tomaszkuehn/Heating-system/ijfw/memory/project-journal.md

<!-- ijfw-schema: v1 -->
# project-journal
- [2026-08-08T21:53:25.724Z] **decision** [esp-idf, sensor, ds18b20, lora, refactor]: Sensor/ przekształcony z .ino do aplikacji ESP-IDF
- [2026-09-24T12:07:08.839Z] **observation** [wt32-eth01, pinout, lora, e32, gpio12, gpio14, datasheet]: WT32-ETH01: IO12/IO14 are GPIO not GND (datasheet)
- [2026-09-24T15:37:29.482Z] **observation** [lora, e32, wt32-eth01, verification, no-remote-node]: LoRa wired; no RX frames — remote node absent (expected)
- [2026-09-24T15:53:58.510Z] **observation** [lora, e32, api, test-endpoint, wiring-debug]: /api/lora/test added; E32 silent — check wiring/variant
- [2026-09-24T17:10:07.536Z] **observation** [ota, rollback, httpd, ethernet, lora, troubleshooting]: OTA interrupted by bad cable; httpd jam; rollback OK
- [2026-09-24T17:13:14.581Z] **observation** [gpio, lora, audit, uart2, strapping]: GPIO audit OK: outputs configured, UART pins valid
- [2026-09-24T17:28:26.508Z] **decision** [git, restructure, submodule, commit, push]: Single repo restructure: submodule dropped, commit 20c5dc2 pushed
- [2026-09-24T20:19:27.060Z] **decision** [lora, security, design, deferred, v2]: LoRa v2 designed, NOT implemented yet (user deferred)
- [2026-09-24T20:37:23.700Z] **observation** [sensor, averaging, health, loss, lora, ota]: 8-sample avg + loss-based health deployed, STALE bug fixed
- [2026-09-26T09:39:26.930Z] **decision** [lora, pairing, hmac, esp32, bugfix]: LoRa PAIR HMAC bug fixed: tag must cover nonce
- [2026-09-26T18:09:52.155Z] **observation** [lora, sensor, bug, ack, arduino, inino]: BUG w Sensor/LoRa_sensor.ino (Arduino, wgrany build = repo, potwierdzone hashem zbudowanego .cpp): ACK kontrolera nigdy nie jest kwitowany, sensor restartuje sie co ~120 s ("No acknowledgement for too
