tomaszkuehn/Heating-system/Heating/main/app_config.h

/**
 * Global hardware / wiring configuration.
 * Centralised so it can be retargeted without touching module logic.
 */
#pragma once

#include "data_model.h"

#ifdef __cplusplus
extern "C" {
#endif

/* ---- GPIO (WT32-ETH01 V1.4 pinout) ----
 * RMII hardwired: GPIO0(clk),18(MDIO),19(TXD0),21(TX_EN),22(TXD1),
 * 23(MDC),25(RXD0),26(RXD1),27(CRS_DV).
 * GPIO16 = LAN8720 + 50 MHz oscillator power enable (must be HIGH).
 * Relocated: heating relay 16->32 (frees PHY power pin).
 * GPIO15 (former net-reset button) and GPIO2 (former LED) are now free:
 * WiFi was removed, so the reset-button watcher no longer exists. */
#define HE_GPIO_HEATING         GPIO_NUM_32   /* relay line to the furnace   */

/* ---- Sensor interface (external board over UART) ----
 * GPIO17 TX is safe; GPIO18 is MDIO → RX moved to GPIO13. */
#define HE_SENSOR_UART          UART_NUM_1
#define HE_SENSOR_UART_TX       GPIO_NUM_17
#define HE_SENSOR_UART_RX       GPIO_NUM_13
#define HE_SENSOR_BAUD          115200
#define HE_SENSOR_BUF_SIZE      256

/* ---- LoRa receiver (radio module Ebyte E32 433T20D).
 *      Receives "TT.TTT T<id>&\r\n" text lines over UART2.
 *      GPIO12/14 are free (not on RMII bus). Mode-control pins moved
 *      off GPIO25/26 (RMII RXD0/RXD1) to GPIO4/5. ---- */
#define HE_LORA_UART            UART_NUM_2
#define HE_LORA_UART_TX         GPIO_NUM_12    /* to module RXD            */
#define HE_LORA_UART_RX         GPIO_NUM_14    /* from module TXD          */
#define HE_LORA_BAUD            9600
#define HE_LORA_BUF_SIZE        256
/* RF channel of the E32 module (LoRa.txt: the node and the controller must
 * transmit on the SAME channel). freq = 410 + channel MHz, so 23 = 433 MHz,
 * which is the E32-433T20D factory default shared by the sensor modules.
 * lora_receiver_init() reads this register back at boot and rewrites it when
 * a field-reconfigured module differs. */
#define HE_LORA_CHANNEL         23             /* 433 MHz (E32 factory)    */
/* Mode-control pins (AUX / TX-RX) on the E32 module. Moved off GPIO25/26
 * (RMII RXD0/RXD1) to safe output pins GPIO4/GPIO5. */
#define HE_GPIO_LORA_AUX        GPIO_NUM_4    /* mode select (0=normal)   */
#define HE_GPIO_LORA_TXRX       GPIO_NUM_5    /* mode select (0=normal)    */
#define HE_LORA_MODE_NORMAL    0
#define HE_LORA_MODE_CONFIG    1
#define HE_LORA_RX_TASK_STACK   3072
#define HE_LORA_LINE_MAX        48             /* max length of one frame  */
/* Nominal period between radio frames from a sensor node. Per LoRa.txt the
 * node sends a measurement every 20 s plus a random 0..2 s delay, so the
 * mean slot is ~21 s. Used for loss-rate estimation and the moving-average
 * window. (lora_receiver.h defines its own HE_LORA_FRAME_PERIOD_MS copy for
 * header users; keep the two in sync.) */
#define HE_LORA_FRAME_PERIOD_MS 21000

/* ---- Ethernet (WT32-ETH01 V1.4 — LAN8720 PHY) ----
 * RMII data pins are hardwired in the ESP32 silicon. 50 MHz clock from the
 * on-board oscillator on GPIO0. PHY address 0. CRITICAL: GPIO16 is the
 * LAN8720 + oscillator power enable — it must be driven HIGH before the
 * PHY is initialised. */
#define HE_ETH_PHY_ADDR        0
#define HE_ETH_PHY_RST_GPIO    (-1)           /* no dedicated reset line */
#define HE_ETH_MDC_GPIO        23
#define HE_ETH_MDIO_GPIO       18
#define HE_ETH_PHY_POWER_GPIO  GPIO_NUM_16    /* LAN8720 power enable (HIGH=on) */
/* Static Ethernet configuration (DHCP client disabled on the ETH netif). */
#define HE_ETH_STATIC_IP       "10.168.34.55"
#define HE_ETH_NETMASK         "255.255.255.0"
#define HE_ETH_GATEWAY         "10.168.34.254"
/* DNS for the static ETH netif. With dhcpc stopped the interface gets NO DNS
 * server, so lwip can't resolve pool.ntp.org and SNTP never syncs the clock
 * (he_time_valid() stays false => minute sampling / charts stay empty). */
#define HE_ETH_DNS_MAIN        "8.8.8.8"
#define HE_ETH_DNS_BACKUP      "8.8.4.4"

/* ---- Control loop timing ---- */
#define HE_CONTROL_TICK_MS      1000          /* control engine period       */
#define HE_SENSOR_POLL_MS       1000          /* how often we poll the iface */
#define HE_BOOST_DURATION_SEC   300           /* 5-minute boost              */
#define HE_SIM_TIME_SCALE       10            /* x10 fast-forward in sim mode */

/* ---- Hysteresis / protection defaults (spec 5.2) ----
 * HE_MIN_ON_SEC / HE_MIN_OFF_SEC / HE_ANTIOSC_LOCK_SEC are the compile-time
 * fallbacks used when a loaded config field is out of range (< the floor). The
 * user-configurable values live in system_config_t (min_on_sec etc., tail
 * fields, set via /api/limits) and default to HE_DEFAULT_* below. */
#define HE_MIN_ON_SEC           90           /* min continuous ON before off allowed */
#define HE_MIN_OFF_SEC          90           /* min continuous OFF before on allowed */
#define HE_MAX_ON_SEC           (3600 * 4)
#define HE_ANTIOSC_LOCK_SEC     120           /* anti-oscillation lock after state change */
#define HE_DEFAULT_MIN_ON_SEC       90       /* user-config: min ON  (range 30..3600) */
#define HE_DEFAULT_MIN_OFF_SEC      90       /* user-config: min OFF (range 30..3600) */
#define HE_DEFAULT_ANTIOSC_LOCK_SEC 120      /* user-config: anti-osc lock (range 30..600) */
#define HE_MIN_ON_OFF_FLOOR     30           /* hard floor for min_on/min_off (anti-chatter) */
#define HE_ANTIOSC_FLOOR        30           /* hard floor for anti-osc lock */

/* ---- Open-window ignore time (cfg v3, /api/limits) ----
 * After a sudden-drop (open-window) detection, the offending sensor stays
 * excluded from the control temperature at least this long before the
 * recovery hysteresis (HE_WINDOW_RECOVERY_HYST) may re-enable it. */
#define HE_DEFAULT_WINDOW_IGNORE_SEC  300    /* 5 minutes                    */
#define HE_WINDOW_IGNORE_MAX_SEC      3600   /* range 0..3600 (0 = no hold)  */

/* ---- Network defaults (spec 12 history) ----
 * The AP SSID/pass defaults only feed the legacy wifi_* fields still present
 * in system_config_t for NVS blob-layout safety; WiFi itself is removed and
 * these fields are inert. */
#define HE_DEFAULT_AP_SSID      "ESP"
#define HE_DEFAULT_AP_PASS      "12345678"    /* WPA2 requires >= 8 chars */

/* ---- Web panel authentication defaults (user/password live in NVS) ---- */
#define HE_DEFAULT_PANEL_USER   "admin"
#define HE_DEFAULT_PANEL_PASS   "12345678"
#define HE_PANEL_PASS_MIN       6             /* min length for a new password */

/* ---- Device identity & protection-limit defaults ---- */
#define HE_DEFAULT_DEVICE_NAME      "Sterownik CO"
#define HE_DEFAULT_SMTP_PORT        25          /* plain-text SMTP submission port */
#define HE_DEFAULT_FAULT_GRACE_SEC  300        /* NO_HEAT_RISE grace (5 min)    */
#define HE_DEFAULT_MAX_ON_SEC       14400      /* max continuous heating (4 h)  */
#define HE_DEFAULT_MAX_ON_BREAK_SEC 600        /* forced break after max-on      */

/* ---- Emergency periodic mode defaults ---- */
#define HE_DEFAULT_EMERGENCY_ENABLED         false
#define HE_DEFAULT_EMERGENCY_ON_SEC          900   /* 15 min ON within the cycle  */
#define HE_DEFAULT_EMERGENCY_PERIOD_SEC      3600  /* 60 min cycle                 */
#define HE_DEFAULT_EMERGENCY_ON_SENSOR_FAULT false /* opt-in: emergency duty cycle when all sensors fail */

/* ---- Anti-flap protection for intermittent sensor links (cfg v4) ----
 * Timeline of a data gap (single sensor): 90 s -> QUAL_TIMEOUT; control keeps
 * the last reading for data_hold; then a silent relay-OFF grace; only then
 * FAULT_SENSOR_IFACE (and the opt-in cyclic emergency, latched for em_hold).
 * Auto-clear requires `recover` seconds of continuous good data. */
#define HE_DEFAULT_SENSOR_DATA_HOLD_SEC   900   /* 15 min stale-data control */
#define HE_DEFAULT_SENSOR_DOWN_GRACE_SEC  900   /* 15 min silent-OFF before fault */
#define HE_DEFAULT_SENSOR_EM_HOLD_MIN     30    /* min stay in emergency (min) */
#define HE_DEFAULT_SENSOR_RECOVER_SEC     300   /* 5 min OK to trust data again */

#ifdef __cplusplus
}
#endif
