tomaszkuehn/Heating-system/Heating/main/control_engine.c

#include "control_engine.h"
#include "app_config.h"
#include "sensor_manager.h"
#include "heating_output.h"
#include "fault_manager.h"
#include "simulation_manager.h"
#include "storage_manager.h"
#include "notification_manager.h"
#include "profile.h"

#include <string.h>
#include <math.h>
#include <time.h>
#include <stdio.h>
#include <stdlib.h>

#include "freertos/FreeRTOS.h"
#include "freertos/task.h"
#include "esp_timer.h"
#include "esp_log.h"

static const char *TAG = "control";

static system_config_t *s_cfg = NULL;
static control_state_t s_state = ST_IDLE;
static control_state_t s_would_be = ST_IDLE;   /* sub-state under SIMULATION */
static bool s_relay = false;
static bool s_boost = false;
static int  s_boost_remaining_ms = 0;
static bool s_disabled = false;

static int64_t s_boot_us;
static int  s_on_ms = 0;            /* continuous ON duration      */
static int  s_off_ms = 0;          /* continuous OFF duration     */
static int64_t s_last_change_us = 0;
static int  s_anti_osc_ms = 0;      /* remaining anti-oscillation lock (scaled) */
static int  s_max_on_break_ms = 0;   /* remaining forced break after max-on       */

static int  s_log_accum_ms = 0;     /* accumulates toward 1-min log */
static int  s_em_phase_ms = 0;      /* emergency cycle phase        */
static int32_t s_virtual_now = 0;   /* shared virtual wall clock (unix sec) */
static int  s_virtual_frac_ms = 0;  /* sub-second remainder for the above  */

/* --- Anti-flap / data-hold state (cfg v4) --- */
static int64_t s_em_sensor_since_us = 0;  /* 0 = emergency not latched (min-stay) */
static bool s_hold_active = false;        /* last tick steered on stale data?     */
static int  s_hold_age_s = 0;             /* age of that data (for the UI banner) */

static int control_now_ms(void) { return (int)((esp_timer_get_time() - s_boot_us) / 1000); }

int control_current_hour(void)
{
    /* Use the shared virtual clock so the hour that drives the heating decision
     * is the SAME hour the chart uses to draw the profile overlay. */
    time_t t = (s_virtual_now != 0) ? (time_t)s_virtual_now : time(NULL);
    if (t >= (time_t)HE_TIME_VALID_EPOCH) {
        struct tm tm; localtime_r(&t, &tm);
        return tm.tm_hour;
    }
    /* Very early boot before the clock is seeded: derive from uptime. */
    return (control_now_ms() / 3600000) % 24;
}

void control_init(void)
{
    s_boot_us = esp_timer_get_time();
    s_state = ST_IDLE;
    s_would_be = ST_IDLE;
    s_last_change_us = s_boot_us;
    /* Fix the timezone at boot so localtime_r is deterministic even offline/AP
     * (before SNTP runs). Must match the browser's zone for the chart's profile
     * overlay to align with the actual switching hour — CET for Poland. */
    setenv("TZ", "CET-1CEST,M3.5.0,M10.5.0/3", 1);
    tzset();
}

void control_bind_config(system_config_t *cfg) { s_cfg = cfg; }

bool control_boost_active(void) { return s_boost; }

void control_request_boost(bool on)
{
    if (on && !s_boost) {
        s_boost = true;
        s_boost_remaining_ms = HE_BOOST_DURATION_SEC * 1000;
        ESP_LOGI(TAG, "BOOST 5min started");
    } else if (!on) {
        s_boost = false;
        s_boost_remaining_ms = 0;
        ESP_LOGI(TAG, "BOOST cancelled");
    }
}

void control_set_heating_disabled(bool disabled)
{
    s_disabled = disabled;
    if (disabled) {
        heating_output_set_relay(false);
        s_relay = false;
        ESP_LOGW(TAG, "heating disabled by user (kill switch)");
    } else {
        ESP_LOGI(TAG, "heating re-enabled");
    }
}

bool control_heating_disabled(void) { return s_disabled; }

void control_clear_fault(void)
{
    s_em_sensor_since_us = 0;   /* UI "Wyczyść awarię": manual bypass wins over the min-stay latch */
    fault_manager_clear();
}

static void enter_state(control_state_t next, control_state_t *target)
{
    if (*target == next) return;
    *target = next;
    s_last_change_us = esp_timer_get_time();
    int aosc = (s_cfg && s_cfg->anti_osc_lock_sec >= HE_ANTIOSC_FLOOR)
               ? s_cfg->anti_osc_lock_sec : HE_ANTIOSC_LOCK_SEC;
    s_anti_osc_ms = aosc * 1000;
    char buf[96];
    snprintf(buf, sizeof(buf), "state->%d", (int)next);
    storage_log_event(FAULT_NONE, 0, buf);
}

/* Drive the emergency cyclic duty cycle from s_cfg->emergency on/period.
 * Shared by the unconditional emergency mode (precedence 3) and the conditional
 * emergency-on-sensor-fault path (precedence 4). Advances the shared s_em_phase_ms
 * accumulator by the time-scaled tick sdt; relay ON while phase < on-window. */
static void emergency_duty(control_state_t *state, bool *relay, int sdt)
{
    int period = s_cfg->emergency.period_seconds * 1000;
    int ontime = s_cfg->emergency.on_seconds * 1000;
    if (period <= 0) period = 3600000;
    if (ontime <= 0) ontime = 900000;
    s_em_phase_ms = (s_em_phase_ms + sdt) % period;
    *state = ST_EMERGENCY_CYCLIC;
    *relay  = (s_em_phase_ms < ontime);
}

/* Decide the relay command from the temperature profile & hysteresis. */
static bool hysteresis_decision(float sys_temp, int hour, bool currently_on)
{
    if (!s_cfg || he_isnan(sys_temp)) return false;
    const profile_hour_t *ph = profile_for_hour(&s_cfg->profile, hour);
    if (!ph) return false;

    bool anti_locked = s_anti_osc_ms > 0;

    /* Forced break after max continuous heating — hard off regardless of temp. */
    if (s_max_on_break_ms > 0) return false;

    int max_on_ms = (s_cfg->max_on_sec > 0) ? s_cfg->max_on_sec * 1000 : 14400000;
    /* User-configurable minimum ON/OFF durations; fall back to the compile-time
     * constant if the stored value is below the anti-chatter floor (defensive
     * against a corrupted NVS read between repair_config and this tick). */
    int min_on_ms  = (s_cfg->min_on_sec  >= HE_MIN_ON_OFF_FLOOR)
                     ? s_cfg->min_on_sec  * 1000 : HE_MIN_ON_SEC  * 1000;
    int min_off_ms = (s_cfg->min_off_sec >= HE_MIN_ON_OFF_FLOOR)
                     ? s_cfg->min_off_sec * 1000 : HE_MIN_OFF_SEC * 1000;

    if (currently_on) {
        /* Safety: force off after continuous heating exceeds the configured limit. */
        if (s_on_ms >= max_on_ms) {
            s_max_on_break_ms = (s_cfg->max_on_break_sec > 0)
                                ? s_cfg->max_on_break_sec * 1000 : 600000;
            return false;
        }
        if (sys_temp >= ph->off_temp && s_on_ms >= min_on_ms && !anti_locked)
            return false;
        return true;
    } else {
        if (sys_temp <= ph->on_temp && s_off_ms >= min_off_ms && !anti_locked)
            return true;
        return false;
    }
}

void control_tick(int dt_ms)
{
    if (!s_cfg) return;

    /* Time scale: fast-forward the whole control loop x10 while accelerated
     * simulation is on, so thermal response, timers, hysteresis and logging all
     * advance in the same virtual clock. */
    int scale = (s_cfg->simulate_heating && s_cfg->sim_time_accel) ? HE_SIM_TIME_SCALE : 1;
    int sdt = dt_ms * scale;
    if (s_anti_osc_ms > 0) { s_anti_osc_ms -= sdt; if (s_anti_osc_ms < 0) s_anti_osc_ms = 0; }
    if (s_max_on_break_ms > 0) { s_max_on_break_ms -= sdt; if (s_max_on_break_ms < 0) s_max_on_break_ms = 0; }

    /* Advance the single shared virtual wall clock BEFORE the hour is read, so
     * the profile lookup for the heating decision, the sample timestamps and the
     * chart's profile overlay all reference the exact same time base. Tracks the
     * real clock when SNTP is set and not accelerated; otherwise it advances by
     * the (x10-scaled) tick so offline / accelerated runs stay self-consistent. */
    if (s_virtual_now == 0)
        s_virtual_now = he_time_valid() ? (int32_t)time(NULL) : (int32_t)HE_TIME_VALID_EPOCH;
    if (scale == 1 && he_time_valid()) {
        s_virtual_now = (int32_t)time(NULL);
    } else {
        s_virtual_frac_ms += sdt;
        while (s_virtual_frac_ms >= 1000) { s_virtual_frac_ms -= 1000; s_virtual_now++; }
    }

    float sys_temp = sensor_manager_system_temp();
    float ext_temp = sensor_manager_external_temp();
    /* Control temperature per the configured source: the weighted system
     * average (CTRL_MODE_AVG), or the coldest of the user-selected sensors
     * (CTRL_MODE_ANY) — any one of them dropping below the profile's lower
     * threshold then turns the heating ON. Falls back to the system average
     * when no selected sensor qualifies (none set / all suppressed / no data). */
    control_mode_t cmode = (s_cfg->control_mode == CTRL_MODE_ANY) ? CTRL_MODE_ANY : CTRL_MODE_AVG;
    float tctrl = sys_temp;
    if (cmode == CTRL_MODE_ANY) {
        float tsel = sensor_manager_control_any_temp();
        if (!he_isnan(tsel)) tctrl = tsel;
    }
    /* Data-hold (cfg v4): when the control source has no FRESH data (LoRa
     * link gap), keep steering on the sensors' last stored reading for up to
     * sensor_data_hold_sec instead of going blind after the 90 s timeout.
     * A deliberate, bounded use of stale data. */
    static bool s_hold_prev = false;
    bool hold_active = false;
    int  hold_age_ms = -1;
    if (he_isnan(tctrl) && s_cfg->sensor_data_hold_sec > 0) {
        float th = sensor_manager_control_hold_temp(cmode == CTRL_MODE_ANY,
                                                    s_cfg->sensor_data_hold_sec,
                                                    &hold_age_ms);
        if (!he_isnan(th)) { tctrl = th; hold_active = true; }
    }
    if (hold_active != s_hold_prev) {
        /* one-shot event-log entry per hold transition (INFO severity) */
        storage_log_event(FAULT_NONE, 0,
                          hold_active ? "data hold: steering on last sensor reading"
                                      : "data hold released: fresh control data");
        s_hold_prev = hold_active;
    }
    s_hold_active = hold_active;
    s_hold_age_s = hold_active ? hold_age_ms / 1000 : 0;
    int hour = control_current_hour();
    int healthy = sensor_manager_healthy_count();
    int total = s_cfg->sensor_count;



    /* Advance thermal simulation if heating simulation is on (spec 8.2). */
    if (s_cfg->simulate_heating) {
        sim_step_thermal(sdt, s_relay, he_isnan(ext_temp) ? 5.0f : ext_temp);
    }

    bool target_relay = false;
    control_state_t target_state = ST_IDLE;

    /* Precedence 1: manual kill switch (spec 11.7). */
    if (s_disabled) {
        target_state = ST_IDLE;
        target_relay = false;
    }
    /* Precedence 2: 5-minute boost (spec 6.2). */
    else if (s_boost) {
        s_boost_remaining_ms -= sdt;
        if (s_boost_remaining_ms <= 0) {
            s_boost = false;
            s_boost_remaining_ms = 0;
            ESP_LOGI(TAG, "BOOST 5min finished");
            target_state = ST_IDLE;
            target_relay = hysteresis_decision(sys_temp, hour, false);
        } else {
            target_state = ST_HEATING;
            target_relay = true;
        }
    }
    /* Precedence 3: emergency periodic mode (spec 6.4) — unconditional duty cycle
     * while emergency is enabled (suppresses normal hysteresis even when sensors
     * are healthy). The conditional sensor-fault variant lives in precedence 4. */
    else if (s_cfg->emergency.enabled) {
        emergency_duty(&target_state, &target_relay, sdt);
    }
    /* Precedence 4: sensor-interface fault with the cyclic emergency engaged
     * (emergency_on_sensor_fault on). The emergency is LATCHED for at least
     * sensor_em_hold_min — a link recovering just 2 min later must not yank
     * the device out of the anti-freeze cycle (anti-flap, cfg v4). The latch
     * releases only when the min stay elapsed AND the fault has cleared (the
     * fault side additionally requires a continuous `sensor_recover_sec` of
     * good data before it reports cleared). Latch state: s_em_sensor_since_us
     * at file scope. */
    int64_t tnow_us = esp_timer_get_time();
    int64_t em_hold_sec = (s_cfg->sensor_em_hold_min > 0)
                          ? (int64_t)s_cfg->sensor_em_hold_min * 60 : 1800;
    bool sensor_fault = fault_manager_current() == FAULT_SENSOR_IFACE;

    /* Release check first: latch set, fault already cleared, stay satisfied. */
    if (!sensor_fault && s_em_sensor_since_us &&
        (tnow_us - s_em_sensor_since_us) >= em_hold_sec * 1000000LL) {
        s_em_sensor_since_us = 0;
    }
    /* Precedence 4a: live fault / latch still engaged. */
    else if (sensor_fault) {
        if (s_cfg->emergency_on_sensor_fault) {
            if (!s_em_sensor_since_us) s_em_sensor_since_us = tnow_us;
            emergency_duty(&target_state, &target_relay, sdt);
        } else {
            target_state = ST_FAULT;
            target_relay = false;
        }
    }
    /* Precedence 4b: fault cleared but min stay not yet elapsed. */
    else if (s_em_sensor_since_us) {
        emergency_duty(&target_state, &target_relay, sdt);
    }
    /* Precedence 4c: any other fault (STORAGE, NO/LOW_HEAT_RISE, SENSOR...) —
     * relay-OFF for safety. FAULT_NETWORK stays out (informational only). */
    else if (fault_manager_current() != FAULT_NONE &&
             fault_manager_current() != FAULT_NETWORK) {
        target_state = ST_FAULT;
        target_relay = false;
    }
    /* Precedence 5: normal hysteresis. */
    else {
        bool decision = hysteresis_decision(tctrl, hour, s_relay);
        target_state = decision ? ST_HEATING : ST_IDLE;
        target_relay = decision;
    }

    /* Pump overrun after a HEATING -> OFF transition (spec 6.3). */
    if (s_state == ST_HEATING && target_state == ST_IDLE && s_cfg->pump.enabled) {
        heating_output_pump_overrun_start(&s_cfg->pump);
        target_state = ST_PUMP_OVERRUN;
        target_relay = false;       /* relay driven by overrun impulses */
    }

    /* Apply relay (heating_output honours simulation rules). */
    if (target_state != ST_PUMP_OVERRUN) {
        heating_output_set_relay(target_relay);
    }

    /* Track on/off durations for hysteresis. */
    if (target_relay) { s_on_ms += sdt; s_off_ms = 0; }
    else              { s_off_ms += sdt; s_on_ms = 0; }

    /* If heating simulation is on, the main state is SIMULATION (spec 8.3)
     * but we keep the computed decision for ON/OFF visualisation. */
    if (s_cfg->simulate_heating) {
        s_would_be = target_state;
        s_state = ST_SIMULATION;
        s_relay = target_relay;     /* shown in UI, not driven to GPIO */
    } else {
        enter_state(target_state, &s_state);
        s_relay = target_relay;
    }

    /* Keep pump overrun ticking while in that state. */
    if (s_state == ST_PUMP_OVERRUN || s_would_be == ST_PUMP_OVERRUN) {
        if (!heating_output_pump_overrun_tick(sdt)) {
            /* overrun finished -> back to IDLE */
            if (s_cfg->simulate_heating) { s_would_be = ST_IDLE; s_state = ST_SIMULATION; }
            else enter_state(ST_IDLE, &s_state);
        }
    }

    /* Feed the fault manager. */
    fault_context_t fctx = {
        .state = s_state,
        .heating_active = s_relay,
        .system_temp = sys_temp,
        .external_temp = ext_temp,
        .healthy_sensors = healthy,
        .total_sensors = total,
        .network_up = fault_manager_network_up(),
        .storage_ok = storage_healthy(),
        .dt_ms = sdt,
    };
    fault_manager_observe(&fctx);

    /* Minute logging (spec 9: record temperatures each minute). Gated on a real
     * (SNTP) wall clock, or on simulation. The sample timestamp is the shared
     * virtual clock (s_virtual_now), which is exactly the same time base the
     * heating decision and the chart's profile overlay use — so the plotted
     * ON/OFF bands line up with when the relay actually switches. */
    s_log_accum_ms += sdt;
    if (s_log_accum_ms >= HE_LOG_INTERVAL_SEC * 1000) {
        s_log_accum_ms -= HE_LOG_INTERVAL_SEC * 1000;
        bool sim = s_cfg->simulate_heating || s_cfg->simulate_sensors;
        if (he_time_valid() || sim) {
            minute_sample_t m = {0};
            m.ts = s_virtual_now;
            m.system_temp = sys_temp;
            m.external_temp = ext_temp;
            m.heating_active = s_relay ? 1 : 0;
            m.state = (uint8_t)s_state;
            for (int i = 0; i < HE_MAX_SENSORS; i++) {
                /* Only sensors with accepted data belong in the per-sensor
                 * history: a fresh slot (e.g. just paired, still in warmup)
                 * has last_effective unset — recording it would plot 0 C. */
                const sensor_t *sp = (i < total) ? &s_cfg->sensors[i] : NULL;
                m.per_sensor[i] = (sp && sp->active &&
                                   (sp->quality == QUAL_OK ||
                                    sp->quality == QUAL_SIMULATED) &&
                                   !he_isnan(sp->last_effective))
                                      ? sp->last_effective : he_nan();
            }
            storage_record_minute(&m);
        }
    }

    /* Restart notification: once, 60s after REAL boot uptime (not the sim-scaled
     * sdt accumulator, which with sim_time_accel x10 fired it at ~7s). Enqueue for
     * off-loop delivery; the worker waits for the network, so no network_up gate
     * here. (#15 / #2) */
    {
        static bool s_restart_notified = false;
        if (!s_restart_notified && control_now_ms() / 1000 >= 60) {
            s_restart_notified = true;
            if ((s_cfg->notify.email_enabled || s_cfg->notify.sms_enabled) &&
                s_cfg->notify_ev_restart) {
                notification_dispatch_restart(&s_cfg->notify,
                    s_cfg->device_name, sys_temp, ext_temp,
                    healthy, total, s_cfg->sensors, s_cfg->sensor_count,
                    s_cfg->has_external, s_cfg->smtp_port);
            }
        }
    }
}

void control_get_snapshot(system_snapshot_t *out)
{
    if (!out) return;
    out->state = s_state;
    out->heating_active = s_relay;
    out->system_temp = sensor_manager_system_temp();
    /* The temperature that actually drives the hysteresis (see control_tick):
     * system average in AVG mode, coldest selected sensor in ANY mode. */
    out->control_temp = out->system_temp;
    out->control_mode = (s_cfg && s_cfg->control_mode == CTRL_MODE_ANY) ? CTRL_MODE_ANY : CTRL_MODE_AVG;
    if (out->control_mode == CTRL_MODE_ANY) {
        float tsel = sensor_manager_control_any_temp();
        if (!he_isnan(tsel)) out->control_temp = tsel;
    }
    out->external_temp = sensor_manager_external_temp();
    out->active_fault = fault_manager_current();
    out->health_ok = (fault_manager_current() == FAULT_NONE || fault_manager_current() == FAULT_NETWORK)
                     && storage_healthy();
    out->hold_active = s_hold_active;
    out->hold_age_s = s_hold_age_s;
    out->uptime_ms = (uint32_t)((esp_timer_get_time() - s_boot_us) / 1000);
    out->simulation_mode = s_cfg ? (s_cfg->simulate_heating || s_cfg->simulate_sensors) : false;
}
