tomaszkuehn/Heating-system/Heating/main/sensor_manager.c

#include "sensor_manager.h"
#include "app_config.h"
#include "storage_manager.h"

#include <string.h>
#include <math.h>
#include <stdlib.h>
#include <time.h>

#include "freertos/FreeRTOS.h"
#include "freertos/task.h"
#include "driver/uart.h"
#include "driver/gpio.h"
#include "esp_timer.h"
#include "esp_log.h"

static const char *TAG = "sensor";

/* Liczba odczytów pomijanych na starcie każdego czujnika — zimny DS18B20
 * potrafi podać zawyżoną temperaturę (samogrzanie / transient startu). */
#define HE_WARMUP_READINGS 3

static sensor_t *s_sensors = NULL;     /* internal sensors */
static int       s_count = 0;
static sensor_t *s_external = NULL;

/* Pozostała liczba odczytów do odrzucenia na starcie (indeks 0 = zewnętrzny,
 * 1..HE_MAX_SENSORS = wewnętrzne). */
static uint8_t s_warmup[HE_MAX_SENSORS + 1];

/* Per-sensor bookkeeping for open-window & stale detection. */
static float  s_baseline[HE_MAX_SENSORS];
static float  s_prev_eff[HE_MAX_SENSORS];
static int64_t s_last_change_us[HE_MAX_SENSORS];
static int64_t s_drift_since_us[HE_MAX_SENSORS];
static uint8_t s_uart_buf[HE_SENSOR_BUF_SIZE];

/* Control/window policy (cfg v3, pushed from web_ui_api/main under the config
 * lock). s_ctrl_mask: bit (id-1) participates in CTRL_MODE_ANY; 0 = all active.
 * s_window_ignore_sec: minimum exclusion time after a sudden-drop detection
 * (0 = immediate recovery per the detection hysteresis). */
static uint8_t s_ctrl_mask = 0;
static int     s_window_ignore_sec = HE_DEFAULT_WINDOW_IGNORE_SEC;
/* Deadline (esp_timer monotone us) until which a window-detected sensor stays
 * excluded regardless of its readings — indexed by sensor table position. */
static int64_t s_window_hold_us[HE_MAX_SENSORS];

static uint32_t mono_ms(void) { return (uint32_t)(esp_timer_get_time() / 1000); }

/* ---- Measurement-buffer diagnostics (UI "Bufor" panel) ----
 * RAM-only chronological ring per sensor id ([0]=external, [1..6]=internal),
 * holding the last HE_MEAS_BUF_LEN measurement events. A period tick in
 * sensor_manager_poll() synthesises a MISS entry for any frame slot that
 * elapsed with no incoming measurement/ERR. Never persisted to NVS. */
typedef struct {
    he_meas_slot_t slots[HE_MEAS_BUF_LEN];
    int            head;            /* next write index                    */
    int            count;           /* valid slots (0..HE_MEAS_BUF_LEN)    */
    uint32_t       next_slot_ms;    /* next expected frame boundary        */
} meas_buf_t;

static meas_buf_t s_meas[HE_MAX_SENSORS + 1];

/* Long-term link counters, indexed like s_meas (1..HE_MAX_SENSORS).
 * s_lt_rx = accepted radio frames (OK + ERR), s_lt_miss = MISS slots.
 * Cumulative since boot; a re-pair keeps counting under the same logical
 * slot, so the % reflects the slot's whole uptime history. */
static uint32_t s_lt_rx[HE_MAX_SENSORS + 1];
static uint32_t s_lt_miss[HE_MAX_SENSORS + 1];

void sensor_manager_link_stats(int id, uint32_t *rx, uint32_t *miss)
{
    if (rx) *rx = (id >= 0 && id <= HE_MAX_SENSORS) ? s_lt_rx[id] : 0;
    if (miss) *miss = (id >= 0 && id <= HE_MAX_SENSORS) ? s_lt_miss[id] : 0;
}

/* Event timestamps: real unix time once SNTP has synced, else uptime seconds
 * (same convention the event log uses so the UI can label an unsynced clock). */
static uint32_t meas_now(void)
{
    if (he_time_valid()) return (uint32_t)time(NULL);
    return (uint32_t)(esp_timer_get_time() / 1000000);
}

/* Map a sensor pointer to its buffer index (0 = external, id = internal). */
static int meas_index(const sensor_t *s)
{
    if (!s) return -1;
    if (s == s_external) return 0;
    for (int i = 0; i < s_count; i++)
        if (&s_sensors[i] == s) return s_sensors[i].id;
    return -1;
}

static void meas_push(int idx, he_meas_kind_t kind, float value)
{
    if (idx < 0 || idx > HE_MAX_SENSORS) return;
    meas_buf_t *b = &s_meas[idx];
    he_meas_slot_t *sl = &b->slots[b->head];
    sl->ts = meas_now();
    sl->value = value;
    sl->kind = kind;
    b->head = (b->head + 1) % HE_MEAS_BUF_LEN;
    if (b->count < HE_MEAS_BUF_LEN) b->count++;
    /* Re-anchor the expected-frame clock to this arrival: sensor nodes send
     * every period +/- jitter, so a free-running grid would fire spurious
     * MISSes right before a late-but-valid frame. */
    b->next_slot_ms = mono_ms() + HE_LORA_FRAME_PERIOD_MS;
}

/* Declare a MISS when no frame has arrived for longer than a period plus a
 * half-period grace (absorbs transmit jitter and the ~1 s poll granularity). */
static void meas_tick(int idx)
{
    if (idx < 0 || idx > HE_MAX_SENSORS) return;
    meas_buf_t *b = &s_meas[idx];
    uint32_t now = mono_ms();
    if (b->next_slot_ms == 0) { b->next_slot_ms = now + HE_LORA_FRAME_PERIOD_MS; return; }
    if ((int32_t)(now - (b->next_slot_ms + HE_LORA_FRAME_PERIOD_MS / 2)) < 0) return;
    meas_push(idx, HE_MEAS_MISS, he_nan());
    s_lt_miss[idx]++;
}

int sensor_manager_get_buffer(int id, he_meas_slot_t *out, int max)
{
    if (!out || max <= 0 || id < 0 || id > HE_MAX_SENSORS) return 0;
    he_config_lock();
    meas_buf_t *b = &s_meas[id];
    int n = b->count < max ? b->count : max;
    int start = ((b->head - b->count) % HE_MEAS_BUF_LEN + HE_MEAS_BUF_LEN) % HE_MEAS_BUF_LEN;
    for (int i = 0; i < n; i++) out[i] = b->slots[(start + i) % HE_MEAS_BUF_LEN];
    he_config_unlock();
    return n;
}

/* ---- CRC8 (poly 0x07) ---- */
static uint8_t crc8(const uint8_t *p, size_t n)
{
    uint8_t c = 0;
    for (size_t i = 0; i < n; i++) {
        c ^= p[i];
        for (int b = 0; b < 8; b++)
            c = (c & 0x80) ? (c << 1) ^ 0x07 : (c << 1);
    }
    return c;
}

void sensor_manager_init(void)
{
    const uart_config_t uc = {
        .baud_rate  = HE_SENSOR_BAUD,
        .data_bits  = UART_DATA_8_BITS,
        .parity     = UART_PARITY_DISABLE,
        .stop_bits  = UART_STOP_BITS_1,
        .flow_ctrl  = UART_HW_FLOWCTRL_DISABLE,
        .source_clk = UART_SCLK_APB,
    };
    int intr_alloc_flags = 0;
    ESP_ERROR_CHECK(uart_driver_install(HE_SENSOR_UART, HE_SENSOR_BUF_SIZE * 2,
                                        HE_SENSOR_BUF_SIZE, 0, NULL, intr_alloc_flags));
    ESP_ERROR_CHECK(uart_param_config(HE_SENSOR_UART, &uc));
    ESP_ERROR_CHECK(uart_set_pin(HE_SENSOR_UART, HE_SENSOR_UART_TX,
                                 HE_SENSOR_UART_RX, UART_PIN_NO_CHANGE,
                                 UART_PIN_NO_CHANGE));

    for (int i = 0; i < HE_MAX_SENSORS; i++) {
        s_baseline[i] = NAN;
        s_prev_eff[i] = NAN;
        s_last_change_us[i] = 0;
        s_drift_since_us[i] = 0;
    }
    memset(s_meas, 0, sizeof(s_meas));
    memset(s_warmup, 0xFF, sizeof(s_warmup));
    ESP_LOGI(TAG, "UART%d initialised for external sensor interface", HE_SENSOR_UART);
}

void sensor_manager_bind(sensor_t *sensors, int count, sensor_t *external)
{
    s_sensors = sensors;
    s_count = count;
    s_external = external;
}

/* Push a raw reading into a sensor's rolling buffer and update effective temp.
 * Returns true when the reading was accepted; false when dropped as a warmup
 * sample. apply_warmup is false for simulation sources (they are synthetic). */
static bool push_reading(sensor_t *s, float raw, bool apply_warmup)
{
    int idx = meas_index(s);
    if (idx < 0 || idx > HE_MAX_SENSORS) return false;

    /* Warmup: odrzuć pierwsze N prawdziwych odczytów po zimnym starcie, by
     * zawyżona początkowa temperatura nie weszła do średniej ani nie oznaczyła
     * czujnika jako zdrowego przed czasem. 0xFF = "jeszcze nie uzbrojony"
     * (nadawany raz, przy pierwszym odczycie wyczerpuje się i NIE uzbraja się
     * ponownie — inaczej pętla: odczyt uzbraja licznik, żaden nigdy nie
     * wchodzi do średniej, sample_count pozostaje 0 i licznik uzbraja się
     * od nowa przy każdej kolejnej ramce). */
    if (apply_warmup) {
        if (s_warmup[idx] == 0xFF && s->sample_count == 0)
            s_warmup[idx] = HE_WARMUP_READINGS;
        if (s_warmup[idx] != 0xFF && s_warmup[idx] > 0) {
            s_warmup[idx]--;
            return false;
        }
    }

    s->last_raw = raw;
    s->samples[s->sample_head] = raw;
    s->sample_head = (s->sample_head + 1) % HE_MOVING_AVG_WINDOW;
    if (s->sample_count < HE_MOVING_AVG_WINDOW) s->sample_count++;

    float sum = 0;
    for (int i = 0; i < s->sample_count; i++) sum += s->samples[i];
    float avg = sum / (float)s->sample_count;
    s->last_effective = avg + s->calib_offset + s->comfort_offset;
    s->last_update_ms = mono_ms();

    /* Diagnostic buffer: record the accepted raw measurement. */
    meas_push(idx, HE_MEAS_OK, raw);
    return true;
}

/* ---- Radio-link loss estimation (spec: yellow at >30% lost) ----
 * On every accepted radio frame, record its arrival time in the per-sensor
 * ring. Between two consecutive arrivals, expected = elapsed / period;
 * missed = expected - 1 (this arrival). Summing over the whole ring span
 * gives loss_pct over a sliding window of up to 8 frames. Frames arriving
 * faster than half the period are treated as duplicates (ignored for loss
 * accounting but still accepted as fresh data). */
void sensor_manager_note_rx(sensor_t *s)
{
    uint32_t now = mono_ms();

    if (s->rx_count == 0) {
        s->rx_ms[s->rx_head] = now;
        s->rx_head = (s->rx_head + 1) % HE_MOVING_AVG_WINDOW;
        s->rx_count = 1;
        s->loss_pct = 0.0f;
        int idx = meas_index(s);
        if (idx >= 0 && idx <= HE_MAX_SENSORS) s_lt_rx[idx]++;
        return;
    }

    int prev = (s->rx_head + HE_MOVING_AVG_WINDOW - 1) % HE_MOVING_AVG_WINDOW;
    uint32_t last = s->rx_ms[prev];
    uint32_t gap = now - last;

    /* Duplicate / burst arrival inside the same slot: refresh timestamp so a
     * retransmission does not distort the gap, but add no loss. */
    if (gap < HE_LORA_FRAME_PERIOD_MS / 2) {
        s->rx_ms[prev] = now;
        return;
    }

    s->rx_ms[s->rx_head] = now;
    s->rx_head = (s->rx_head + 1) % HE_MOVING_AVG_WINDOW;
    if (s->rx_count < HE_MOVING_AVG_WINDOW) s->rx_count++;
    int lt_idx = meas_index(s);
    if (lt_idx >= 0 && lt_idx <= HE_MAX_SENSORS) s_lt_rx[lt_idx]++;

    /* Loss over the covered span. With only 2 slots we know 1 interval;
     * with k slots we know k-1 intervals: use the newest interval only
     * when the ring is not yet full, and the full span when it is. */
    if (s->rx_count >= 2) {
        int oldest = s->rx_head;   /* after advance, head == oldest slot */
        uint32_t span = now - s->rx_ms[oldest];
        int intervals = s->rx_count - 1;
        if (intervals > 0 && span > 0) {
            int expected = (int)((span + HE_LORA_FRAME_PERIOD_MS / 2) /
                                 HE_LORA_FRAME_PERIOD_MS);
            int missed = expected - intervals;
            if (missed < 0) missed = 0;   /* clock jitter tolerance */
            float pct = 100.0f * (float)missed /
                        (float)(missed + intervals);
            s->loss_pct = pct;
        }
    }
}

/* True when the reading is back within the recovery hysteresis of the
 * window-detection baseline (the drop that opened the window has healed). */
static bool drop_ok(const sensor_t *s, int idx)
{
    return (s_baseline[idx] - s->last_effective) < HE_WINDOW_RECOVERY_HYST;
}

/* Open-window detection (spec 6.1): rate of drop + comparison with others.
 * On detection the sensor stays excluded from the control temperature for at
 * least window_ignore_sec (configurable hold), and until its reading recovers
 * within HE_WINDOW_RECOVERY_HYST of the baseline. Both transitions go to the
 * shared event log so the panel history shows the incident. */
static void window_detect(sensor_t *s, int idx)
{
    if (idx < 0 || idx >= HE_MAX_SENSORS) return;

    if (s->window_open) {
        /* Stay suppressed at least for the user-configured hold time, then
         * re-enable when the temperature recovers within the hysteresis. */
        bool hold_elapsed = (s_window_ignore_sec <= 0) ||
                            (esp_timer_get_time() >= s_window_hold_us[idx]);
        if (!hold_elapsed) return;
        if (drop_ok(s, idx)) {
            s->window_open = false;
            s->quality = s->simulated ? QUAL_SIMULATED : QUAL_OK;
            s_baseline[idx] = s->last_effective;
            ESP_LOGI(TAG, "sensor %d: window closed, restored", s->id);
            char buf[96];
            snprintf(buf, sizeof(buf), "S%d (%s): okno zamknięte", s->id, s->name);
            storage_log_event(FAULT_NONE, 0, buf);
        }
        return;
    }

    if (s->quality != QUAL_OK && s->quality != QUAL_SIMULATED) return;
    if (isnan(s_baseline[idx])) {
        s_baseline[idx] = s->last_effective;
        return;
    }
    float drop = s_baseline[idx] - s->last_effective;

    /* Compare this sensor's drop with the average drop of the other active,
     * non-suppressed sensors: only a localised, fast drop indicates a window,
     * avoiding false positives during whole-building cool-down (spec 6.1). */
    float other_drop_sum = 0; int other_n = 0;
    for (int k = 0; k < s_count; k++) {
        if (k == idx) continue;
        sensor_t *o = &s_sensors[k];
        if ((o->quality == QUAL_OK || o->quality == QUAL_SIMULATED) && !o->window_open
            && !isnan(s_baseline[k])) {
            other_drop_sum += (s_baseline[k] - o->last_effective);
            other_n++;
        }
    }
    float other_drop = other_n ? other_drop_sum / other_n : 0;

    if (drop > 1.5f && (drop - other_drop) > 1.0f) {
        s->window_open = true;
        s->quality = QUAL_WINDOW_OPEN;
        s_window_hold_us[idx] = esp_timer_get_time() +
                                (int64_t)s_window_ignore_sec * 1000000LL;
        ESP_LOGW(TAG, "sensor %d (%s): open window detected", s->id, s->name);
        char buf[96];
        snprintf(buf, sizeof(buf), "S%d (%s): gwałtowny spadek (okno?) — ignoruję %d s",
                 s->id, s->name, s_window_ignore_sec);
        storage_log_event(FAULT_NONE, 1, buf);
    } else {
        /* slowly adapt baseline toward current to track gradual changes */
        s_baseline[idx] = s_baseline[idx] * 0.95f + s->last_effective * 0.05f;
    }
}

/* Stale / drift detection (spec 4). */
static void stale_detect(sensor_t *s, int idx)
{
    if (idx < 0 || idx >= HE_MAX_SENSORS) return;
    /* A radio-fed sensor reporting a genuinely stable room temperature is not
     * "stale" — the probe is fine, the physics is just quiet. Drift/stale
     * detection only makes sense for polled wired probes. */
    if (s->rx_count > 0) return;
    int64_t now = esp_timer_get_time();
    if (isnan(s_prev_eff[idx])) { s_prev_eff[idx] = s->last_effective; s_last_change_us[idx] = now; return; }

    if (fabsf(s->last_effective - s_prev_eff[idx]) > 0.05f) {
        s_prev_eff[idx] = s->last_effective;
        s_last_change_us[idx] = now;
        s_drift_since_us[idx] = 0;
    } else if ((now - s_last_change_us[idx]) > 10LL * 60 * 1000000LL) {
        /* No meaningful change for >10 min. */
        if (s->quality == QUAL_OK) s->quality = QUAL_STALE;
    }
    s_prev_eff[idx] = s->last_effective;
}

/* Parse a response frame: [START][len][payload][crc][END], payload=[count][id,t_hi,t_lo]... */
static bool parse_frame(const uint8_t *buf, int len)
{
    if (len < 4 || buf[0] != HE_FRAME_START || buf[len - 1] != HE_FRAME_END) return false;
    int plen = buf[1];
    if (len != plen + 4) return false;
    if (crc8(buf + 2, plen + 1) != buf[len - 2]) {
        ESP_LOGW(TAG, "frame CRC mismatch");
        return false;
    }
    const uint8_t *p = buf + 2;
    int n = p[0]; p++;
    if (n > s_count + 1) n = s_count + 1;
    for (int i = 0; i < n; i++) {
        uint8_t id = p[0];
        int16_t centi = (int16_t)((p[1] << 8) | p[2]);
        p += 3;
        float t = centi / 100.0f;
        /* route by id: 1..6 internal, 0 external. A disabled external sensor is
         * skipped so a real interface frame can't revive it. */
        sensor_t *target = NULL;
        if (id == 0 && s_external && s_external->active) { target = s_external; }
        else if (id >= 1 && id <= HE_MAX_SENSORS) {
            for (int k = 0; k < s_count; k++) if (s_sensors[k].id == id) { target = &s_sensors[k]; break; }
        }
        if (!target) continue;
        if (t > HE_TEMP_MAX_ACCEPT) {
            ESP_LOGW(TAG, "sensor id %u: rejected %.2f C (bogus > %.0f)",
                     (unsigned)id, t, HE_TEMP_MAX_ACCEPT);
            continue;
        }
        if (!push_reading(target, t, true)) continue;
        if (t < HE_TEMP_MIN_LOGICAL || t >= HE_TEMP_MAX_LOGICAL)
            target->quality = QUAL_OUT_OF_RANGE;
        else if (target->active && !target->window_open)
            target->quality = target->simulated ? QUAL_SIMULATED : QUAL_OK;
    }
    return true;
}

static bool request_poll(uint8_t *out, int *outlen)
{
    uint8_t frame[6];
    frame[0] = HE_FRAME_START;
    frame[1] = 1;                 /* payload len */
    frame[2] = HE_CMD_POLL;
    frame[3] = crc8(&frame[2], 1);
    frame[4] = HE_FRAME_END;
    uart_write_bytes(HE_SENSOR_UART, frame, 5);
    /* Read response with a bounded wait. */
    int total = 0, got = 0;
    int64_t deadline = esp_timer_get_time() + 100000; /* 100 ms */
    while (esp_timer_get_time() < deadline && total < (int)sizeof(s_uart_buf)) {
        got = uart_read_bytes(HE_SENSOR_UART, s_uart_buf + total,
                              sizeof(s_uart_buf) - total, pdMS_TO_TICKS(20));
        if (got > 0) {
            total += got;
            if (total >= 4 && s_uart_buf[1] + 4 == total) break;
        }
    }
    if (total < 4) return false;
    *outlen = total;
    memcpy(out, s_uart_buf, total);
    return true;
}

void sensor_manager_poll(void)
{
    uint8_t buf[HE_SENSOR_BUF_SIZE];
    bool got_real = false;
    int outlen = 0;

    /* First, fill simulated sensors from the simulation manager. */
    for (int i = 0; i < s_count; i++) {
        sensor_t *s = &s_sensors[i];
        if (!s->active) { s->quality = QUAL_DISABLED; continue; }
        if (s->simulated) {
            float v = sim_produce_reading(s);
            if (he_isnan(v)) { s->quality = QUAL_TIMEOUT; continue; }
            push_reading(s, v, false);
            if (v < HE_TEMP_MIN_LOGICAL || v > HE_TEMP_MAX_LOGICAL)
                s->quality = QUAL_OUT_OF_RANGE;
            else
                s->quality = QUAL_SIMULATED;
        }
    }
    /* External sensor honours its active flag exactly like the internal ones:
     * when disabled it produces no reading, reports DISABLED, and does not feed
     * weather compensation or the thermal model (a disabled sensor is ignored). */
    if (s_external) {
        if (!s_external->active) {
            s_external->quality = QUAL_DISABLED;
        } else if (s_external->simulated) {
            float v = sim_produce_reading(s_external);
            if (!he_isnan(v)) { push_reading(s_external, v, false); s_external->quality = QUAL_SIMULATED; }
        }
    }

    /* If any sensor is still real, poll the hardware interface. */
    bool need_real = false;
    for (int i = 0; i < s_count; i++)
        if (s_sensors[i].active && !s_sensors[i].simulated) { need_real = true; break; }
    if (need_real) got_real = request_poll(buf, &outlen);

    if (need_real) {
        if (got_real) {
            parse_frame(buf, outlen);
        } else {
            /* Interface unreachable: mark real sensors TIMEOUT. */
            for (int i = 0; i < s_count; i++)
                if (s_sensors[i].active && !s_sensors[i].simulated)
                    if ((mono_ms() - s_sensors[i].last_update_ms) > HE_SENSOR_TIMEOUT_SEC * 1000)
                        s_sensors[i].quality = QUAL_TIMEOUT;
        }
    }

    /* Validation passes for real sensors that received data this poll. */
    for (int i = 0; i < s_count; i++) {
        sensor_t *s = &s_sensors[i];
        if (!s->active) {
            s->quality = QUAL_DISABLED;
            /* A disabled sensor can't be in window-open state; clear any stale flag
             * left from when it was active so the UI never shows the ⊗ mark for a
             * sensor that is no longer being polled. */
            s->window_open = false;
            /* Radio bookkeeping is meaningless while disabled. */
            s->rx_count = 0;
            s->loss_pct = 0.0f;
            continue;
        }
        if (s->simulated) { continue; }
        if (s->quality == QUAL_OK) {
            if ((mono_ms() - s->last_update_ms) > HE_SENSOR_TIMEOUT_SEC * 1000)
                s->quality = QUAL_TIMEOUT;
        }
        /* Radio-linked sensors: no arrival for a full window means every
         * expected frame in that window was lost -> force the loss estimate
         * upward instead of leaving it frozen at the last arrival. */
        if (s->rx_count > 0) {
            uint32_t since = mono_ms() - s->rx_ms[(s->rx_head + HE_MOVING_AVG_WINDOW - 1) % HE_MOVING_AVG_WINDOW];
            uint32_t win = (uint32_t)HE_MOVING_AVG_WINDOW * HE_LORA_FRAME_PERIOD_MS;
            if (since > win + HE_LORA_FRAME_PERIOD_MS) {
                s->loss_pct = 100.0f;
            }
        }
    }

    /* Open-window and stale/drift checks (skip external). window_detect is
     * also invoked while quality == QUAL_WINDOW_OPEN so the recovery path
     * (hold timer + hysteresis) can re-enable the sensor; for wired probes
     * parse_frame deliberately keeps the WINDOW_OPEN quality while suppressed,
     * and the same guard on the LoRa path keeps the flag stable there. */
    for (int i = 0; i < s_count; i++) {
        sensor_t *s = &s_sensors[i];
        if (s->quality == QUAL_OK || s->quality == QUAL_SIMULATED ||
            s->quality == QUAL_WINDOW_OPEN) {
            window_detect(s, i);
            if (s->quality == QUAL_OK || s->quality == QUAL_SIMULATED)
                stale_detect(s, i);
        }
    }

    /* Advance the diagnostic frame-slot clock for every radio-linked sensor so
     * a gap in transmissions turns into MISS entries in the UI buffer. */
    for (int i = 0; i < s_count; i++) {
        sensor_t *s = &s_sensors[i];
        if (s->active && !s->simulated && s->radio_id != 0)
            meas_tick(s->id);
    }
}

float sensor_manager_system_temp(void)
{
    float wsum = 0, vsum = 0;
    for (int i = 0; i < s_count; i++) {
        sensor_t *s = &s_sensors[i];
        if (!s->active) continue;
        if (s->quality != QUAL_OK && s->quality != QUAL_SIMULATED) continue;
        if (he_isnan(s->last_effective)) continue;
        wsum += s->weight;
        vsum += s->weight * s->last_effective;
    }
    if (wsum <= 0) return he_nan();
    return vsum / wsum;
}

/* Weighted mean over one minute sample restricted to the sensors that CONTROL
 * the heating (mask semantics as in sensor_manager_control_any_temp). The
 * sample already stores NaN for sensors without an accepted reading at record
 * time; weight and mask come from the CURRENT config. Storage computes the
 * daily `daily.csv` system column for the 12-month chart from this, so the
 * plotted long-term average follows the control set, not all sensors. */
float sensor_manager_ctrl_minute_avg(const float *vals, int n)
{
    if (!vals || !s_sensors) return he_nan();
    float wsum = 0, vsum = 0;
    for (int i = 0; i < n && i < s_count; i++) {
        const sensor_t *s = &s_sensors[i];
        if (!s->active) continue;
        if (he_isnan(vals[i])) continue;
        /* bit (id-1) participates; mask 0 = all internal sensors qualify. */
        if (s_ctrl_mask &&
            !(s_ctrl_mask & (uint8_t)(1u << ((s->id - 1) & 7u)))) continue;
        wsum += s->weight;
        vsum += s->weight * vals[i];
    }
    if (wsum <= 0) return he_nan();
    return vsum / wsum;
}

/* Control temperature from STALE data (data-hold window, see header). Same
 * selection and weighting as the live control temperature, but quality is
 * deliberately ignored — a link gap is exactly when TIMEOUT/STALE is all we
 * have — and readings older than the hold window do not qualify. */
float sensor_manager_control_hold_temp(bool coldest, int hold_sec, int *age_ms)
{
    if (age_ms) *age_ms = -1;
    if (!s_sensors || hold_sec <= 0 || s_count <= 0) return he_nan();
    uint32_t now = mono_ms();
    float wsum = 0, vsum = 0, best = he_nan();
    int worst_age_ms = -1;
    for (int i = 0; i < s_count; i++) {
        sensor_t *s = &s_sensors[i];
        if (!s->active || he_isnan(s->last_effective)) continue;
        /* bit (id-1) participates in control; mask 0 = all internal sensors. */
        if (s_ctrl_mask &&
            !(s_ctrl_mask & (uint8_t)(1u << ((s->id - 1) & 7u)))) continue;
        int age = (int)(now - s->last_update_ms);
        if (age < 0) age = 0;
        if (age > hold_sec * 1000) continue;
        if (age > worst_age_ms) worst_age_ms = age;
        if (coldest) {
            if (he_isnan(best) || s->last_effective < best)
                best = s->last_effective;
        } else {
            wsum += s->weight;
            vsum += s->weight * s->last_effective;
        }
    }
    if (age_ms) *age_ms = worst_age_ms;
    if (coldest) return he_isnan(best) ? he_nan() : best;
    if (wsum <= 0) return he_nan();
    return vsum / wsum;
}

/* Control-temperature for CTRL_MODE_ANY: coldest among the user-selected
 * sensors. A sensor qualifies when it is active, quality-OK (or simulated),
 * has a reading, and its id bit is set in s_ctrl_mask (0 = all internal
 * sensors qualify). Window-suppressed and external sensors never count.
 * NAN when nothing qualifies — the control engine falls back to AVG. */
float sensor_manager_control_any_temp(void)
{
    float mn = he_nan();
    for (int i = 0; i < s_count; i++) {
        sensor_t *s = &s_sensors[i];
        if (!s->active) continue;
        if (s->quality != QUAL_OK && s->quality != QUAL_SIMULATED) continue;
        if (he_isnan(s->last_effective)) continue;
        if (s_ctrl_mask &&
            !(s_ctrl_mask & (uint8_t)(1u << ((s->id - 1) & 7u)))) continue;
        if (he_isnan(mn) || s->last_effective < mn) mn = s->last_effective;
    }
    return mn;
}

void sensor_manager_set_ctrl_mask(uint8_t mask) { s_ctrl_mask = mask; }

void sensor_manager_set_window_ignore(int ignore_sec)
{
    if (ignore_sec < 0) ignore_sec = 0;
    if (ignore_sec > HE_WINDOW_IGNORE_MAX_SEC) ignore_sec = HE_WINDOW_IGNORE_MAX_SEC;
    s_window_ignore_sec = ignore_sec;
}

float sensor_manager_external_temp(void)
{
    if (!s_external || !s_external->active) return he_nan();
    if (s_external->quality != QUAL_OK && s_external->quality != QUAL_SIMULATED)
        return he_nan();
    return s_external->last_effective;
}

int sensor_manager_healthy_count(void)
{
    int n = 0;
    for (int i = 0; i < s_count; i++)
        if (s_sensors[i].quality == QUAL_OK || s_sensors[i].quality == QUAL_SIMULATED) n++;
    return n;
}

void sensor_manager_restore(int id)
{
    for (int i = 0; i < s_count; i++) {
        if (s_sensors[i].id == id) {
            s_sensors[i].window_open = false;
            s_baseline[i] = s_sensors[i].last_effective;
            s_sensors[i].quality = s_sensors[i].simulated ? QUAL_SIMULATED : QUAL_OK;
            ESP_LOGI(TAG, "sensor %d manually restored", id);
            return;
        }
    }
}

bool sensor_manager_radio_bound(int radio_id)
{
    /* Caller holds the config lock (same convention as lora_update/err).
     * True when any internal sensor slot still carries this paired radio id;
     * after /api/lora/unpair deletes the last binding the id becomes free. */
    if (radio_id < 1 || radio_id > HE_MAX_SENSORS) return false;
    for (int k = 0; k < s_count; k++)
        if (s_sensors[k].radio_id == radio_id) return true;
    return false;
}

void sensor_manager_lora_update(int id, float temperature)
{
    /* Route by the paired radio id (radio_id), NOT the logical sensor id:
     * a sensor's LoRa node can be paired to any free radio id independently
     * of where it sits in the sensor table. A disabled or simulated sensor
     * is ignored so a radio frame can't revive or override a sensor the
     * user turned off or replaced with a simulation source. */
    if (id < 1 || id > HE_MAX_SENSORS) return;
    if (isnan(temperature)) return;

    sensor_t *target = NULL;
    for (int k = 0; k < s_count; k++) {
        if (s_sensors[k].radio_id == id) { target = &s_sensors[k]; break; }
    }
    if (!target) return;
    if (!target->active || target->simulated) return;

    /* Bogus reading (e.g. DS18B20 power-on 85.0): ignore entirely — no moving
     * average update, no quality change. */
    if (temperature > HE_TEMP_MAX_ACCEPT) {
        ESP_LOGW(TAG, "radio T%d: rejected %.2f C (bogus > %.0f)",
                 id, temperature, HE_TEMP_MAX_ACCEPT);
        return;
    }

    if (!push_reading(target, temperature, true)) return;
    sensor_manager_note_rx(target);
      if (temperature < HE_TEMP_MIN_LOGICAL || temperature >= HE_TEMP_MAX_LOGICAL)
          target->quality = QUAL_OUT_OF_RANGE;
      else if (!target->window_open)
          target->quality = QUAL_OK;   /* keep QUAL_WINDOW_OPEN while suppressed */
}

void sensor_manager_lora_err(int radio_id)
{
    /* Probe-failure marker (ERR frame) from a node: keep the sensor's last
     * value but log an ERR entry in its diagnostic buffer and count the frame
     * arrival so it is not also counted as a MISS. */
    if (radio_id < 1 || radio_id > HE_MAX_SENSORS) return;
    sensor_t *target = NULL;
    for (int k = 0; k < s_count; k++) {
        if (s_sensors[k].radio_id == radio_id) { target = &s_sensors[k]; break; }
    }
    /* Record the event even when the node is not bound/active so the UI buffer
     * still shows what arrived on the radio link. */
    int idx = target ? meas_index(target) : radio_id;
    meas_push(idx, HE_MEAS_ERR, he_nan());
    if (target) sensor_manager_note_rx(target);
}
