tomaszkuehn/Heating-system/Heating/main/fault_manager.c

#include "fault_manager.h"
#include "notification_manager.h"
#include "app_config.h"

#include <string.h>
#include <math.h>
#include <stdio.h>

#include "esp_timer.h"
#include "esp_log.h"

static const char *TAG = "fault";

static system_config_t *s_cfg = NULL;
static fault_class_t s_fault = FAULT_NONE;
static char s_text[96] = "";
static bool s_net_up = true;
static bool s_notified = false;

/* Rate-limit the on-disk log: a flapping fault (raise/clear/re-raise, e.g.
 * NO_HEAT_RISE <-> SENSOR_IFACE while sensors wobble available/unavailable) would
 * otherwise fill events.log with repeated entries seconds apart. The fault state
 * and the one-shot notification still update immediately; only the persistent log
 * write is throttled to at most one entry per fault class per minute. */
static int64_t s_last_log_us = 0;
static fault_class_t s_last_log_fault = FAULT_NONE;

/* Expected thermal response model (spec 7: not a naive "temp not rising"). */
static float s_heat_start_temp;
static int64_t s_heat_start_us;
static bool s_heating_was_active = false;
static float s_learned_rate = 0.5f;   /* degC per minute, EMA over good cycles */

/* --- Anti-flap timing for the sensor-interface fault (cfg v4) ---
 * A LoRa link with minutes-long gaps would previously trip FAULT_SENSOR_IFACE
 * on the first unhealthy tick (control had NO debounce) and clear it on the
 * first good one — engaging the cyclic emergency over and over. Now:
 *  - raise only after hold+grace seconds of accumulated all-sensors-down
 *    (hold = the deliberate control-side stale-data window, grace = extra
 *    silent-OFF margin; both from system_config_t, 0 disables each part).
 *    The credit ACCUMULATES across flaps: a brief data burst does not reset
 *    it — only a continuous recovery of sensor_recover_sec does,
 *  - auto-clear only after that same continuous recovery window. */
static uint32_t s_down_ms = 0;   /* continuous all-internal-sensors-down  */
static uint32_t s_ok_ms = 0;     /* continuous at-least-one-healthy       */

void fault_manager_init(void)
{
    s_fault = FAULT_NONE;
    s_heat_start_us = 0;
    s_heating_was_active = false;
    s_learned_rate = 0.5f;
}

void fault_manager_bind_config(system_config_t *cfg) { s_cfg = cfg; }

void fault_manager_set_network_up(bool up)
{
    if (up != s_net_up) {
        s_net_up = up;
        if (!up) {
            ESP_LOGW(TAG, "network down");
        } else {
            ESP_LOGI(TAG, "network up");
        }
    }
}

bool fault_manager_network_up(void) { return s_net_up; }

static void raise_fault(fault_class_t f, const char *text)
{
    if (f == s_fault) return;
    s_fault = f;
    strncpy(s_text, text, sizeof(s_text) - 1);
    s_text[sizeof(s_text) - 1] = '\0';
    ESP_LOGW(TAG, "fault raised: %d (%s)", (int)f, text);
    /* Throttle the persistent log to <=1/min per fault class. The fault state
     * above and the notification below still fire immediately; this only stops a
     * rapidly flapping fault from spamming events.log. */
    int64_t now_us = esp_timer_get_time();
    if (!(s_last_log_fault == f && now_us - s_last_log_us < 60 * 1000000LL)) {
        storage_log_event(f, 2, text);
        s_last_log_fault = f;
        s_last_log_us = now_us;
    }
    /* Dispatch the alert only when the user subscribes to fault notifications
     * (notify_ev_faults, default ON to preserve the pre-feature behavior). The
     * dispatch is off-loop and one-shot per fault lifecycle (s_notified resets on
     * clear), so a re-raise after recovery+failure fires a fresh notification. */
    if (s_cfg && !s_notified && s_cfg->notify_ev_faults) {
        notification_dispatch_alert(&s_cfg->notify, f, text, s_cfg->smtp_port);
        s_notified = true;
    }
}

void fault_manager_clear(void)
{
    if (s_fault != FAULT_NONE) ESP_LOGI(TAG, "fault cleared");
    s_fault = FAULT_NONE;
    s_text[0] = '\0';
    s_notified = false;
}

fault_class_t fault_manager_current(void) { return s_fault; }
const char *fault_manager_text(void) { return s_text; }
bool fault_manager_heating_healthy(void) { return s_fault != FAULT_NO_HEAT_RISE && s_fault != FAULT_LOW_HEAT_RISE; }
float fault_manager_learned_rate(void) { return s_learned_rate; }

void fault_manager_observe(const fault_context_t *ctx)
{
    if (!ctx) return;

    /* --- Heating response model --- */
    if (ctx->heating_active && !s_heating_was_active) {
        s_heat_start_temp = ctx->system_temp;
        s_heat_start_us = esp_timer_get_time();
        s_heating_was_active = true;
    } else if (!ctx->heating_active && s_heating_was_active) {
        /* Heating just stopped: update the learned rate from this cycle if it rose. */
        int64_t dur_us = esp_timer_get_time() - s_heat_start_us;
        float minutes = (float)(dur_us / 1000) / 60000.0f;
        if (minutes > 1.0f && !he_isnan(ctx->system_temp) && !he_isnan(s_heat_start_temp)) {
            float rise = ctx->system_temp - s_heat_start_temp;
            if (rise > 0.1f) {
                float rate = rise / minutes;
                s_learned_rate = s_learned_rate * 0.7f + rate * 0.3f;
            }
        }
        s_heating_was_active = false;
    }

    /* --- Sensor / interface faults (anti-flap: see the timing block above) --- */
    if (ctx->total_sensors > 0 && ctx->healthy_sensors == 0) {
        s_ok_ms = 0;
        if (s_fault != FAULT_SENSOR_IFACE) {
            s_down_ms += (uint32_t)ctx->dt_ms;
            int hold = (s_cfg && s_cfg->sensor_data_hold_sec > 0) ? s_cfg->sensor_data_hold_sec : 0;
            int grace = (s_cfg && s_cfg->sensor_down_grace_sec > 0) ? s_cfg->sensor_down_grace_sec : 900;
            if (s_down_ms >= (hold + grace) * 1000u) {
                raise_fault(FAULT_SENSOR_IFACE, "all sensors unavailable");
                s_down_ms = 0;
                return;   /* control drops to emergency/ST_FAULT from the next tick */
            }
            /* Silence shorter than hold+grace: no fault yet — the control
             * engine serves the stale-data hold (then relay-OFF) this whole
             * window. No early return: storage/network checks stay live. */
        }
    } else {
        if (ctx->healthy_sensors > 0) s_ok_ms += (uint32_t)ctx->dt_ms; else s_ok_ms = 0;
        /* IMPORTANT: a single frame / short data burst does NOT clear the
         * silence credit (s_down_ms is frozen, not reset while data trickles
         * in). Only a CONTINUOUS recovery period (sensor_recover_sec) proves
         * the link back — otherwise a flapping link (e.g. one frame every few
         * minutes) would reset the clock forever and the anti-freeze
         * emergency could never engage no matter how bad the link got. */
        int rec = (s_cfg && s_cfg->sensor_recover_sec > 0) ? s_cfg->sensor_recover_sec : 300;
        if (s_ok_ms >= rec * 1000u) {
            s_down_ms = 0;
            if (s_fault == FAULT_SENSOR_IFACE) {
                fault_manager_clear();
                s_ok_ms = 0;
            }
        }
    }

    /* --- Storage fault --- */
    if (!ctx->storage_ok) {
        raise_fault(FAULT_STORAGE, "storage/filesystem error");
        return;
    }

    /* fault_grace_sec == 0 (e.g. from an upgraded/short-read NVS blob) must NOT
     * collapse the grace to zero and trip NO_HEAT_RISE on the first heating tick.
     * Fall back to the default when the field is missing or invalid. */
    int grace_ms = (s_cfg && s_cfg->fault_grace_sec > 0)
                   ? s_cfg->fault_grace_sec * 1000 : 300000;

    /* Opt-out for installations where the rise model doesn't apply (e.g. very
     * slow floor heating): never raise heat-rise faults, and release a
     * latched one (it can't self-clear — the latched fault holds the relay
     * OFF, so the effectiveness check below would never run again). */
    bool ignore_rise = s_cfg && s_cfg->ignore_heat_rise;
    if (ignore_rise &&
        (s_fault == FAULT_NO_HEAT_RISE || s_fault == FAULT_LOW_HEAT_RISE)) {
        fault_manager_clear();
    }

    /* --- Heating effectiveness (only while heating, after grace) --- */
    if (!ignore_rise &&
        ctx->heating_active && !he_isnan(ctx->system_temp) && !he_isnan(s_heat_start_temp)) {
        int64_t since_us = esp_timer_get_time() - s_heat_start_us;
        if (since_us > grace_ms * 1000LL) {
            float minutes = (float)(since_us / 1000) / 60000.0f;
            float observed = (ctx->system_temp - s_heat_start_temp) / minutes;
            /* Expected rate corrected for outdoor temperature: colder outside
             * means higher losses, so a lower net rise is still acceptable. */
            float ext = he_isnan(ctx->external_temp) ? 5.0f : ctx->external_temp;
            float expected = s_learned_rate - 0.01f * (ctx->system_temp - ext);
            if (expected < 0.05f) expected = 0.05f;
            if (observed <= 0.0f) {
                raise_fault(FAULT_NO_HEAT_RISE, "no temperature rise while heating");
                return;
            } else if (observed < expected * 0.5f) {
                raise_fault(FAULT_LOW_HEAT_RISE, "heating rise below expected (airlock/valve?)");
                return;
            }
        }
    }

    /* --- Network fault (informational, does not block control) --- */
    if (!ctx->network_up && s_fault == FAULT_NONE) {
        raise_fault(FAULT_NETWORK, "network unavailable");
        return;
    }

    /* Clear network fault automatically when reconnected. */
    if (ctx->network_up && s_fault == FAULT_NETWORK) {
        fault_manager_clear();
    }
    /* (The historical instant auto-clear for FAULT_SENSOR_IFACE
     * (`healthy > 0 -> clear immediately`) was REMOVED — it bypassed the
     * recover gate above and re-introduced flapping: with a flickering link
     * every single returned frame re-armed the cycle. The ONLY paths out of
     * FAULT_SENSOR_IFACE are now: a continuous `sensor_recover_sec` of good
     * data (gate in the else-branch), or the manual "Wyczyść awarię" (UI/API).) */
    /* Clear heating faults when heating becomes effective again. */
    if ((s_fault == FAULT_NO_HEAT_RISE || s_fault == FAULT_LOW_HEAT_RISE) &&
        ctx->heating_active && !he_isnan(ctx->system_temp) && !he_isnan(s_heat_start_temp)) {
        int64_t since_us = esp_timer_get_time() - s_heat_start_us;
        if (since_us > grace_ms * 1000LL) {
            float minutes = (float)(since_us / 1000) / 60000.0f;
            float observed = (ctx->system_temp - s_heat_start_temp) / minutes;
            if (observed >= s_learned_rate * 0.5f) fault_manager_clear();
        }
    }
}
