tomaszkuehn/Heating-system/(commit log)

2026-08-08 Initial commit: heating system with sensor node and controller
    - Sensor: ESP32 + DS18B20 + LoRa E32 (Sensor/)
    - Controller: ESP32 + LoRa receiver + web UI (Heating/ submodule)
    - Shared text protocol: 'TT.TTT T<id>&\r\n' over 9600 8N1 UART
    - ACK byte 'X' from controller to sensor
    - .gitignore for ESP-IDF build, logs, node_modules, workspace state
    - Workspace config: opencode.json, .opencode/, .ijfw/
    [partitions.csv]
2026-09-24 Merge Heating controller source into single repo; drop submodule
    - Remove Heating submodule gitlink + .gitmodules: Heating/ and Sensor/ now
    live as plain folders in one root repo (old Heating repo deleted).
    - Add all Heating controller sources (main/, web/, partitions, sdkconfig.defaults).
    - Add module datasheets: WT32-ETH01, E32-433T20D (Sensor/).
    - Update .gitignore: ignore ijfw/, .claude/, firmware/, managed sdkconfig.
    - Auth (panel login/sessions) + OTA self-confirm + LoRa test endpoint included.
    [partitions.csv]
2026-09-24 Sensor averaging window 8 + radio loss health indicator
    - Moving-average window 7 -> 8 samples per sensor (buffer of the last
    8 raw readings; control/UI consume their average).
    - Per-sensor radio loss estimation: ring of the last 8 frame arrival
    times, nominal node cadence HE_LORA_FRAME_PERIOD_MS = 6 s; duplicates
    (gap < period/2) refresh the marker without counting as data;
    loss_pct = 100*missed/(missed+intervals) over the sliding window;
    forced to 100% after a full silent window; disabled sensors reset.
    - Health dot per sensor: green <= 30% loss, yellow > 30% (HE_LOSS_WARN_PCT),
    red = no data, gray = disabled; /api/state exposes loss and rx fields.
    - Fix: stale detection no lon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
    [app_config.h, data_model.h, sensor_manager.c, sensor_manager.h, web_ui_api.c]
2026-09-25 LoRa node pairing + repair via web UI; fix 1-Wire bus timing (mode-switching)
    Controller:
    - /api/lora/pair GET (request status + free radio ids) / POST (assign id,
    auto-create sensor slots), /api/lora/repair POST (change node id)
    - pair_broadcast lengthened to ~6 s (30x200 ms) so the command lands inside
    the node's 5 s ACK window once per ~7 s cycle
    - ERR T& frames no longer misread as T00 pairing announcements (NaN temp)
    - web UI: pairing modal (free id list + detected node status, poll 5 s),
    per-row 'ID...' button for radio sensors, banner button
    Node (Sensor):
    - 1-Wire rewrite of slot timing to mirror the proven Arduino OneWire library:
    INPUT/OUTPUT mode switching instead of open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
    [app_config.h, lora.c, lora.h, lora_receiver.c, lora_receiver.h, main.c, onewire.c, onewire.h]
2026-09-25 Show all detected LoRa devices with their radio ids in pairing UI
2026-09-25 Fix pairing scanner false positives: init node ages to -1
    [lora_receiver.c]
2026-09-25 LoRa sensor lifecycle: factory reset (EN hold/unpair cmd), live pairing scan, delete with confirm
    [app_config.h, lora_receiver.c, lora_receiver.h, main.c, web_ui_api.c]
2026-09-25 Verified unpair (3-cycle watch, force fallback); radio id decoupled from sensor id
2026-09-25 Fix NVS layout: radio_id tail-appended + corrupted-blob recovery
    [data_model.h, main.c]
2026-09-25 Pairing concept: factory id 0, only T00 pairable, RESET restores 0
    [lora_receiver.c, lora_receiver.h, main.c, web_ui_api.c]
2026-09-25 Factory reset: LED hint at 5s hold, erase+reboot on release
    [app_config.h, main.c]
2026-09-25 Rapid-reboot factory reset: EN hold detected via NVS boot counter
    [main.c]
2026-09-25 Fix WDT boot loop; timed factory reset on BOOT (5s hold lights LED, erases id on release)
    [app_config.h, main.c]
2026-09-25 Factory reset in pairing_loop too; LED self-test (3 blinks) at boot
    [main.c]
2026-09-25 Sensor: BOOT reset task + WDT worker subscriptions; Ctrl: LoRa rx/tx logs, unique pair id
    [lora_receiver.c, main.c, web_ui_api.c]
2026-09-25 LoRa frames (rx/tx/ack/broadcast) logged to UI event log
2026-09-26 feat: add Arduino LoRa_sensor.ino with binary magic 0x02 0xE3 protocol
    - Add Sensor/LoRa_sensor.ino: Arduino implementation using binary frame
    format <0x02 0xE3><payload>T<ID># instead of text 'TT.TTT T<id>&'
    - Add LoRa.txt: protocol spec for the binary Arduino sensor
    - Sensor/README.md: document Arduino alternative (LoRa_sensor.ino) and
    binary frame format differences vs ESP-IDF version
    - Heating/README.md: document the Arduino binary protocol variant handled
    by the controller alongside the ESP-IDF text protocol
    - Fix LoRa.txt example to clarify magic is 2 raw bytes (0x02 0xE3), not ASCII '02E3'
    Verified: sensor reports 'Frame: \x02\xE321.875T0#' over LoRa,
    controller ACK confirmed e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
    [LoRa_sensor.ino]
2026-09-26 LoRa: binary-only pairing (PR<id>T9#), channel sync, orange TX log; docs update
    - Controller pairs with binary 02 E3 PR<id>T9# only; drop text PAIR/HMAC (lora_sec removed from controller)
    - E32 RF channel sync to HE_LORA_CHANNEL=23; /api/lora/config?chan=N endpoint
    - Accept binary frames (02 E3 ...#) alongside text; ACK 02 E3 X<id>T9#; ERR payload
    - LoRa frame period 6000->21000 ms (LoRa.txt: 20 s + 0..2 s)
    - UI: transmitted frames (lora tx:) highlighted orange in the event log
    - Docs: dual protocol, pairing, channel, known Arduino ACK bug (documented, not fixed)
    [app_config.h, lora_receiver.c, lora_receiver.h, lora_sec.c, lora_sec.h, main.c, web_ui_api.c]
2026-09-26 Fix phantom unpaired-node banner: age announcements by wall clock, show banner only for id 0
    - lora_rx_task: age s_pair_nodes by esp_timer once per second, independent of frame arrivals (was behind got<=0, so a stale T0 lingered ~30 frames/10 min instead of 30 s TTL)
    - app.js pollPair: show unpaired banner only for node id 0, not the first node in the list
    [lora_receiver.c]
2026-09-26 Fix empty charts: correct ETH gateway and add static DNS so SNTP syncs
    - app_config.h: HE_ETH_GATEWAY was 10.168.34.1 (unreachable); real gateway is 10.168.34.254, so the static netif had no internet route. Added HE_ETH_DNS_MAIN/BACKUP (8.8.8.8/8.8.4.4; the gateway does not serve DNS).
    - network_manager.c: with dhcpc stopped the ETH netif got no DNS servers, so lwip could not resolve pool.ntp.org and SNTP never synced. time_synced stayed false, which gates minute sampling in control_engine.c -> /api/samples and /api/daily were empty (blank charts). Set DNS explicitly via esp_netif_set_dns_info.
    [app_config.h, network_manager.c]
2026-09-26 Add per-sensor measurement buffer (OK/ERR/MISS) with /api/sensor/buffer and UI panel
2026-09-26 Fix sensor ACK timeout underflow: refresh now after sendMeasurement, signed compare
    [LoRa_sensor.ino]
2026-10-01 Clamp protection limits against garbage NVS; chart hover crosshair; docs
2026-10-01 Note in UI that emergency mode ignores sensor readings
2026-10-01 Browser-tab favicon mirrors boiler status; charts reload on re-login and survive a failed /api/samples fetch
2026-10-04 Sensor: one same-frame retransmit after ACK timeout (Balkon/Pokoj frame loss)
    Payload is stored per measurement; on ACK timeout the node boosts to HIGH power and resends the identical frame once before falling back to the old no-stall behavior. Resend budget resets on every new measurement; the ACK handler accepts either the original or the retry.
2026-10-17 LoRa: verified async pairing (PR retries, slot only after T<n> confirm), bogus>60C cutoff, warmup re-arm fix, E32 forced 20 dBm; relay active-low; Sensor: binary PR pairing, 20 s+jitter cadence; docs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
2026-10-18 LoRa: wylacznie protokol binarny 02 E3 (LoRa.txt) — node: ramki <magic><payload>T<id># + ERR + ACK X + parowanie PR + power-dance wg spec (usuniety legacy tekstowy T<n>& i PAIR HMAC); kontroler: ramk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
2026-10-18 LoRa: ogloszenia T0 bez ACK X0 — wg LoRa.txt X jest potwierdzeniem pomiaru zarejestrowanego sensora; okno parowania wezla zamyka sie po dowolnej poprawnej linii, wiec zbędny X0 scadzil ogloszenia do 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
2026-10-18 UI: wiersz 'Nowy czujnik — w trakcie parowania' na liscie czujnikow — placeholder podczas zadania parowania (startUnpairWatch ustawia pendingPair, renderSensors rysuje wiersz placeholder i czysci go 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
2026-10-18 LoRa: ramki ID bez zarejestrowanego czujnika bez ACK — X<id> wg LoRa.txt potwierdza pomiar zarejestrowanego sensora, wiec po /api/lora/unpair kontroler przestaje potwierdzac dawny wezel (sensor_manag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
2026-10-18 Fix parowania: pair_verify_note(id) przed bramka 'brak czujnika, bez ack' — węzeł PR dopiero co przybrał ID N i nie ma jeszcze slota (powstaje w on_result), więc potwierdzające ogłoszenie T<N> musilo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
2026-10-18 UI: etykiety checkboxow nad wykresem temperatury = nazwa czujnika ucieta do pierwszych 12 znakow (pelna nazwa w tooltipie title), a render() przebudowuje toggles po kazdym pelnym odswiezeniu -> zmian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
2026-10-18 Docs: README — status parowania z rid + wznowienie UI, potwierdzenie ogloszeniem T<n> przed bramka ACK, wiersz placeholder 'Nowy czujnik — w trakcie parowania', etykiety legendy wykresu ucinane do 12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
2026-10-18 Chore: sprzatanie repo — usuniete scratch-pliki debugowania z lini komend (login/state/OTA dump), untracking stanu narzedzi (.ijfw, .opencode, ijfw -> zignorowane calkowicie), dodane read_serial.py i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
2026-10-18 UI: pasek korekty profilu dobowego — przyciski +/-1 i +/-0.25 dla wszystkich 24 par OFF/ON (klient trzyma przerwe histerezy, clamp do zakresu logicznego -40..85), badge z laczna korekta delta, reset 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
2026-10-18 UI: pasek korekty profilu chowa sie z panelem — flex przeniesiony z inline style do klasy .profile-toolbar (inline display nadpisywal regule collapse karty)
2026-10-19 network: WiFi removed (Ethernet-only device); drop /api/network + net-reset button; docs
2026-11-04 docs: FAULT_SENSOR_IFACE - single-frame clear window (recover <= 90 s) and sparse-cadence emergency lock-in note
